DimaOliinyk/KeyboardScannerWithPLD/GAL22V10.png

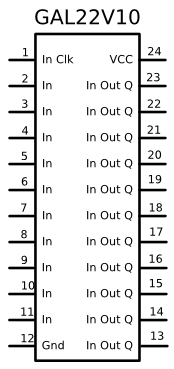
GAL22V10.png
